tpII/2026-a5-mano-simulada-dmp/informes/images/gy9250.png

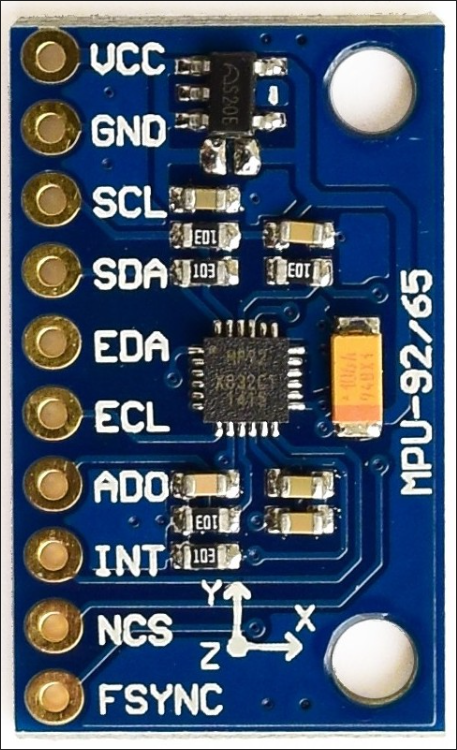
informes/images/gy9250.png
