tpII/2026-a5-mano-simulada-dmp/documentacion/imagenes/prototipo_sensores_esp.jpeg

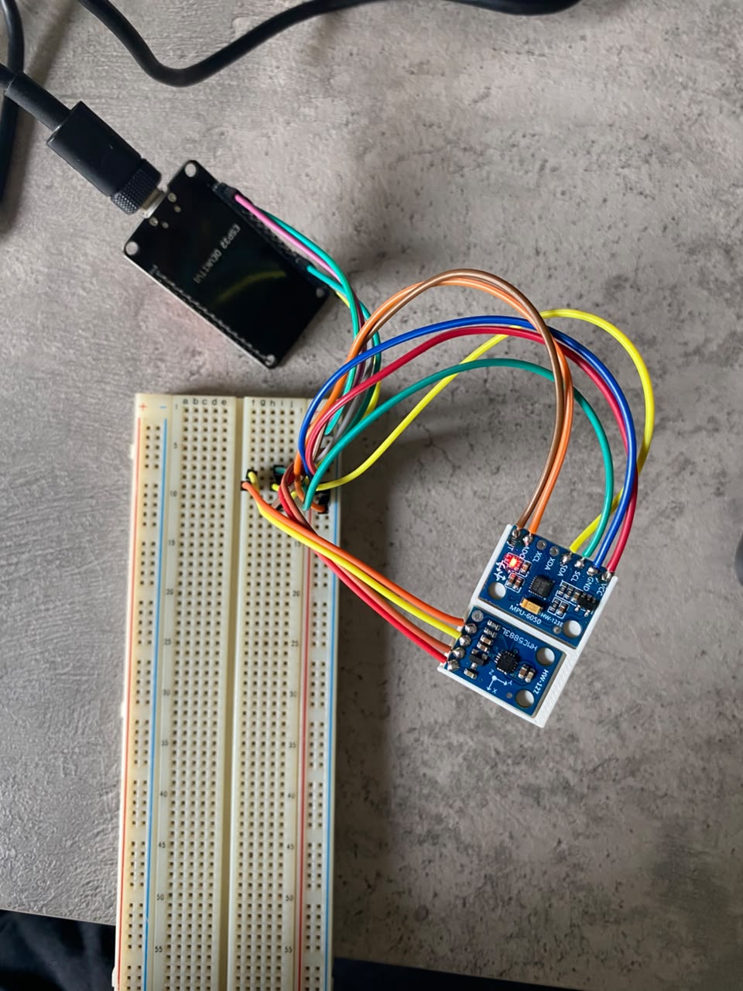
documentacion/imagenes/prototipo_sensores_esp.jpeg
