tpII/2026-a5-mano-simulada-dmp/documentacion/entregas/E3/README.md

# Entrega E3

Carpeta reservada. Contenido pendiente de incorporar.
