tpII/2026-a5-mano-simulada-dmp/firmware/src/comunicacion/README.md

# Comunicación del dispositivo

Carpeta reservada. Contenido pendiente de incorporar.
