tpII/2026-a5-mano-simulada-dmp/firmware/src/dmp/README.md

# Integracion del DMP

Carpeta reservada. Contenido pendiente de incorporar.
