tpII/2026-a5-mano-simulada-dmp/InformeInicial/images/diagrama_bloque.png

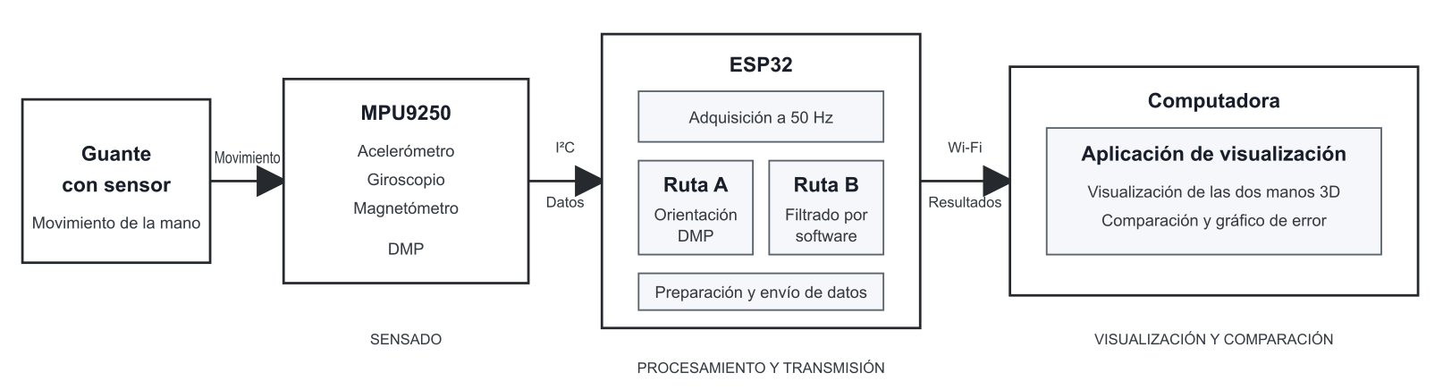
InformeInicial/images/diagrama_bloque.png
