tpII/2026-a5-mano-simulada-dmp/informes/images/Esquema.png

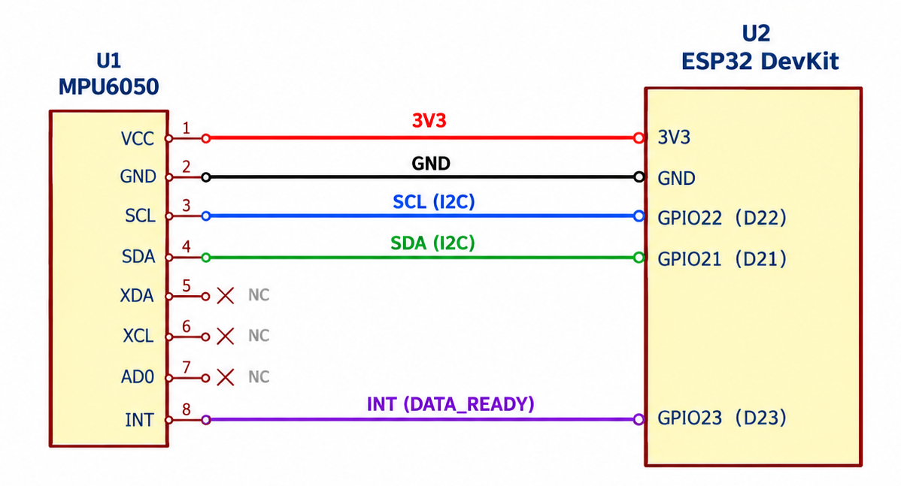
informes/images/Esquema.png
