tpII/2026-a5-mano-simulada-dmp/informes/images/mpu9250.png

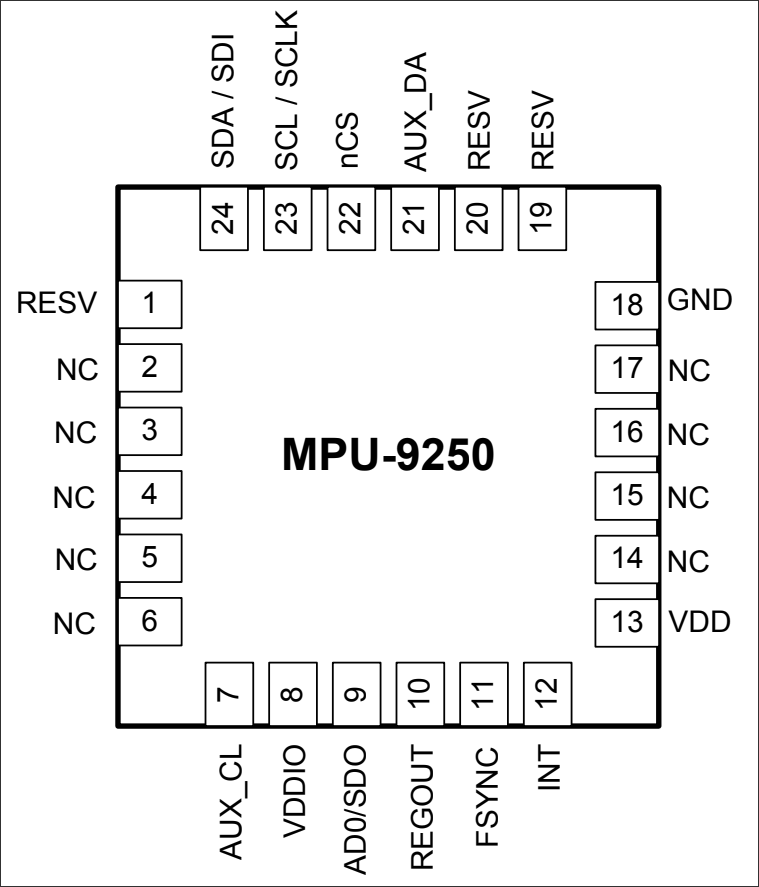
informes/images/mpu9250.png
