tpII/2026-a5-mano-simulada-dmp/informes/images/mpu9250_i2c.png

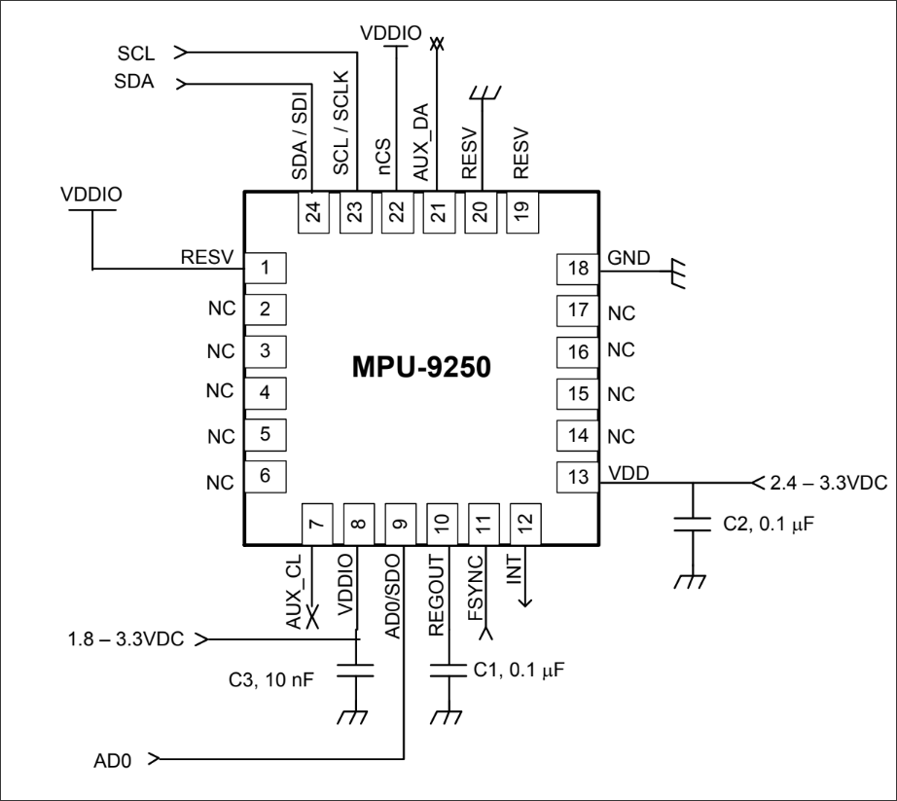
informes/images/mpu9250_i2c.png
