tpII/2026-a5-mano-simulada-dmp/firmware/src/calibracion/README.md

# Calibracion de sensores

Carpeta reservada. Contenido pendiente de incorporar.
