tpII/2026-a5-mano-simulada-dmp/manosimulada/pruebas/visualizador.html

# A5 · Visualizador MPU6050

Datos del firmware modular real (I²C + DATA_READY a 50 Hz) · orientación estimada temporalmente en el navegador

Conectar ESP32DesconectarCentrar orientación

Sin conectar115200 baudios

Vista 3D · componentes arriba · pines hacia vos (borde inferior de la foto)

X: derecha de la fotoY: hacia el borde opuesto a los pinesZ: hacia arriba de los componentes

## Lecturas

Roll0.0°

Pitch0.0°

Yaw relativo0.0°

Frecuencia recibida—

Ax (m/s²)—

Ay (m/s²)—

Az (m/s²)—

Gz (rad/s)—

Modelo orientado como el módulo de tu foto: pines en el borde delantero, componentes visibles y Z perpendicular a la placa. La adquisición y el filtro complementario de roll y pitch se calculan en el ESP32. El navegador únicamente representa los ángulos recibidos. El yaw se obtiene integrando el giroscopio: acumula deriva y no representa un rumbo absoluto.

0 muestras recibidas

Requiere Chrome o Edge de escritorio con Web Serial, y abrir esta página desde http://localhost (por ejemplo, python -m http.server 8000). Cerrá antes el Monitor Serie de Arduino IDE.
