tpII/2026-a5-mano-simulada-dmp/firmware/src/comunicacion/wifi.h

#pragma once

namespace RedWifi {
// Crea la red propia ManoDMP, sin intentar conectarse al router.
void iniciarRedPropia();

// Alternativa desactivada: ver el bloque comentado en wifi.cpp.
// void iniciarConRouter();
} // namespace RedWifi
