tpII/2026-a5-mano-simulada-dmp/manosimulada/pruebas MPU6050 + magnetometro/test_dmp/i2c.h

#ifndef I2C_H
#define I2C_H

#include <stdint.h>
#include <stddef.h>

#ifdef __cplusplus
extern "C" {
#endif

    // Inicializar bus I2C
    void i2c_init(void);

    // Escribir un registro
    int i2c_escribir_registro(uint8_t direccion , uint8_t registro , uint8_t valor);

    // Leer uno o varios registros consecutivos
    int i2c_leer_registros(uint8_t direccion , uint8_t registro , uint8_t* buffer , size_t longitud);

#ifdef __cplusplus
}
#endif

#endif
