tpII/2026-a5-mano-simulada-dmp/(commit log)

2026-09-09 borrador plan de proyecto
2026-09-12 diagrama de flujo
2026-09-13 diagrama de bloques
2026-09-29 version preliminar de comunicación I2C y access point
2026-10-02 se adaptó el código para funcionar con el mpu (sin dmp ni magnetómetro)
2026-10-11 DMP MPU6050 y Datos MPU + magnetometro
2026-10-11 Visualizador con magnetometro
2026-10-11 version final informe de avance octubre
2026-10-12 agrego el video
2026-10-25 readme
    Removed sections on firmware execution, prototype reproduction, documentation, and telemetry testing from the README.
2026-11-03 Kalman + calibración magnetometro
2026-11-05 borrador informe de avance noviembre
2026-11-09 informe de avance noviembre
